ausandavno/ISA_POST_Card_v5/README.md

# ISA_POST_Card_v5
A plug-in diagnostic card that displays Power On Self Test (POST) codes on an 8-bit ISA data bus. Tested for use with Micro8088 and Xi8088 systems. Can be configured to listen on any address in the lower ten bits of address space. 

Current version v5.1
