ausandavno/ISA_POST_Card_v5/v5.1/CAD/README.md

Various footprints, symbols, and 3D models that may be required for KiCad to import the project correctly.
