ausandavno/ISA_POST_Card_v5/v5.1/Images/ISA_Post_Card_v5.1_3.PNG

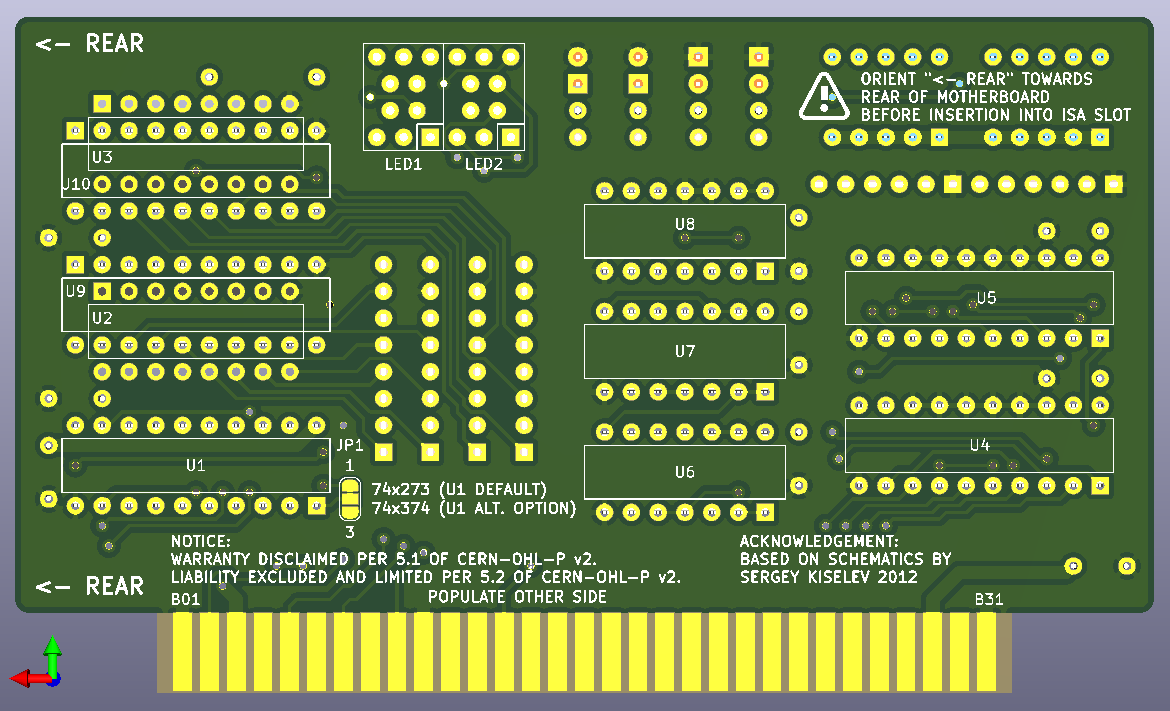
v5.1/Images/ISA_Post_Card_v5.1_3.PNG
