ausandavno/ISA_POST_Card_v5/v5.1/CAD/LTS_2801AG_Assembly.stp

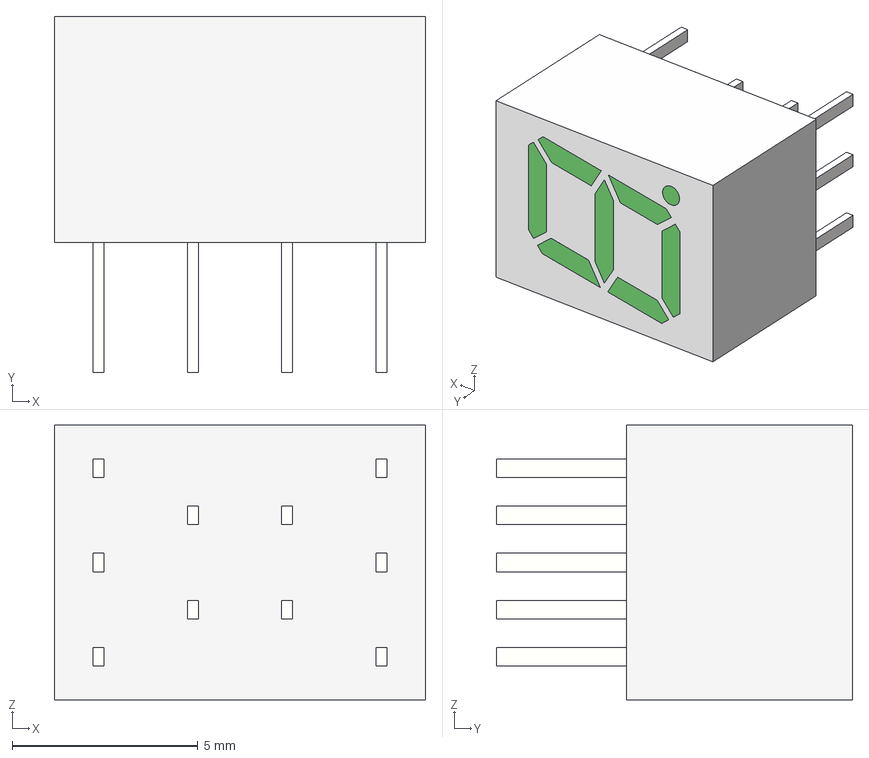
[picture p4: CAD file, 2022-04-07]
v5.1/CAD/LTS_2801AG_Assembly.stp
10.0 x 9.60 x 7.40 mm
