ausandavno/ISA_POST_Card_v5/v5.1/PCB_Layout/ISA_POST_Card_v5.1-B_Cu.pdf

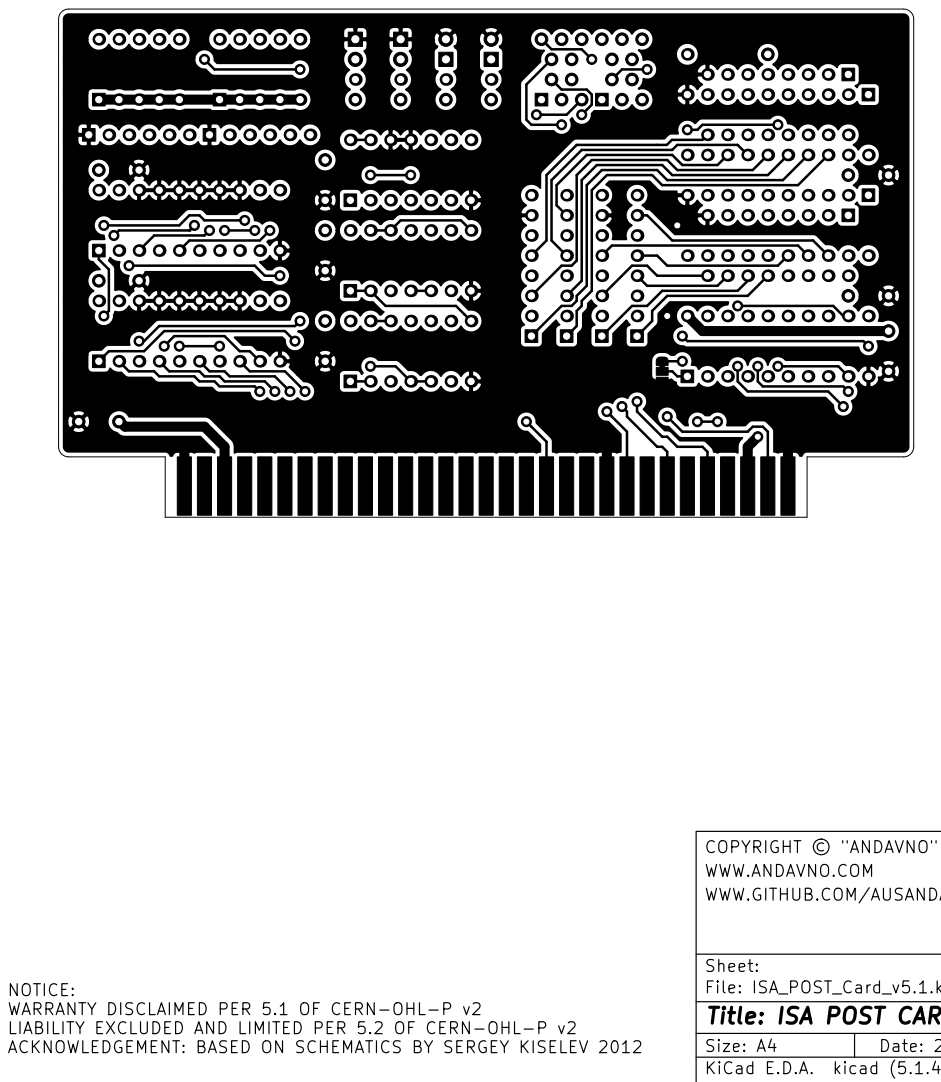
[picture p5: page 1]

COPYRIGHT © "ANDAVNO" 2022
ACKNOWLEDGEMENT: BASED ON SCHEMATICS BY SERGEY KISELEV 2012 WWW.GITHUB.COM/AUSANDAVNO WWW.ANDAVNO.COM

Id: 1/1 Title: ISA POST CARD v5.1

WARRANTY DISCLAIMED PER 5.1 OF CERN-OHL-P v2

LIABILITY EXCLUDED AND LIMITED PER 5.2 OF CERN-OHL-P v2
