ausandavno/ISA_POST_Card_v5/v5.1/Schematics/ISA_POST_Card_v5.1-Schematic.pdf

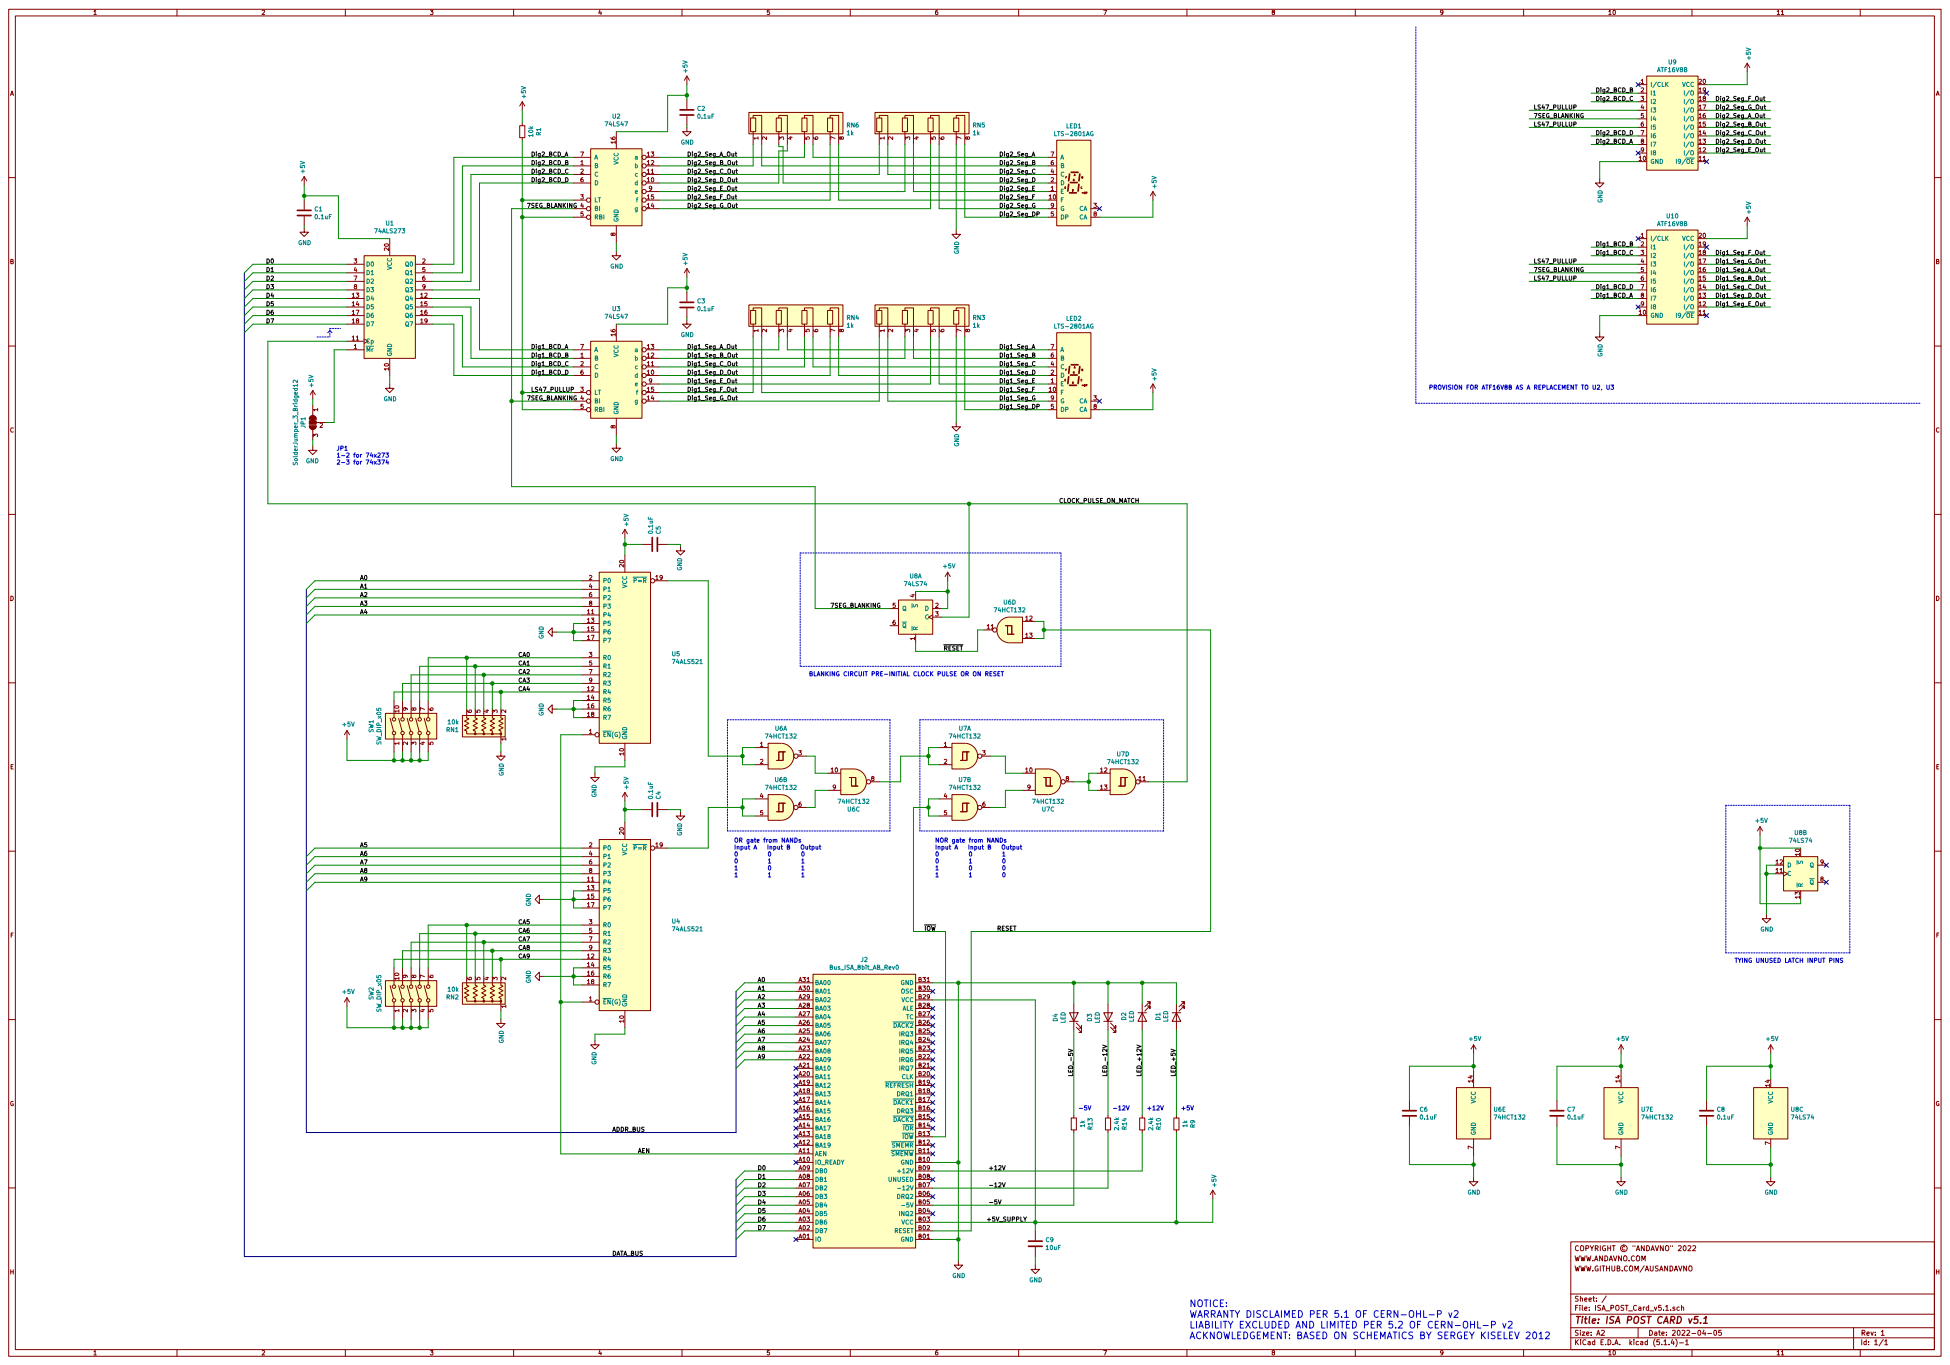
[picture p6: page 1]

Dig2_Seg_F
Dig2_Seg_G
Dig2_Seg_DP

Dig1_Seg_F
Dig1_Seg_G
Dig1_Seg_DP

PROVISION FOR ATF16V8B AS A REPLACEMENT TO U2, U3

OR gate from NANDs

TYING UNUSED LATCH INPUT PINS

File: ISA_POST_Card_v5.1.sch Sheet: / WWW.GITHUB.COM/AUSANDAVNO WWW.ANDAVNO.COM

WARRANTY DISCLAIMED PER 5.1 OF CERN-OHL-P v2
LIABILITY EXCLUDED AND LIMITED PER 5.2 OF CERN-OHL-P v2
ACKNOWLEDGEMENT: BASED ON SCHEMATICS BY SERGEY KISELEV 2012

Id: 1/1 Title: ISA POST CARD v5.1
