ausandavno/ISA_POST_Card_v5/v5.1/ISA_POST_Card_v5.1.kicad_pcb

## KiCad design v5.1/ISA_POST_Card_v5.1.kicad_pcb (2022-04-07)

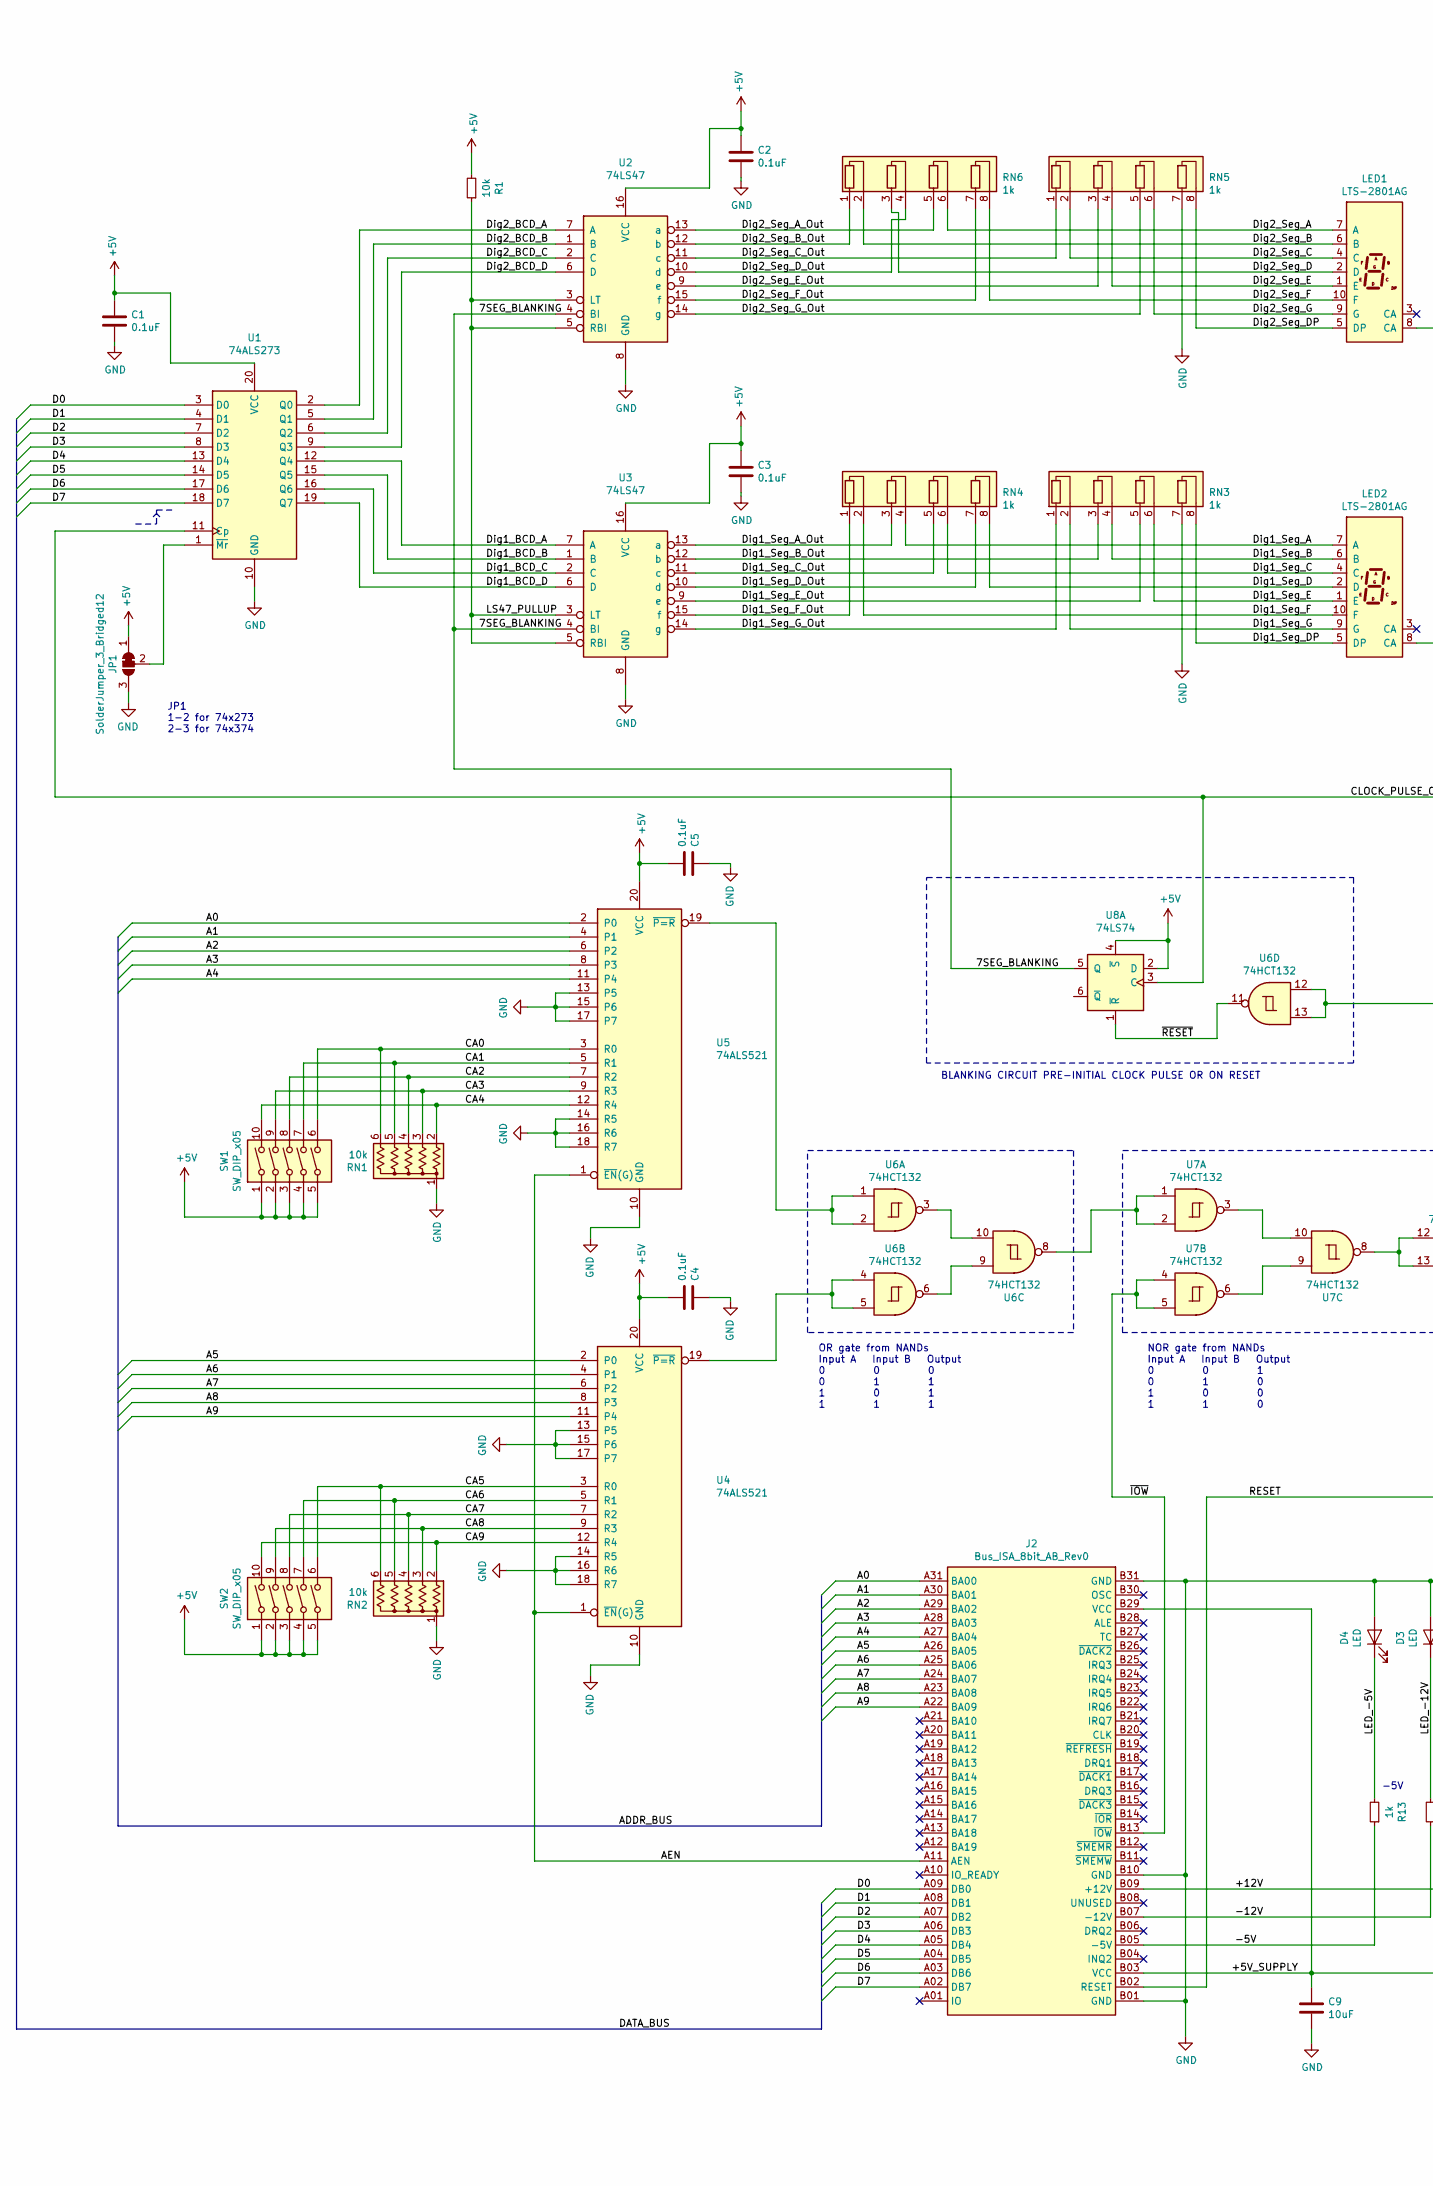
[picture p7: schematic ISA_POST_Card_v5.1.sch, ISA POST CARD v5.1, part in row 1, column 1]

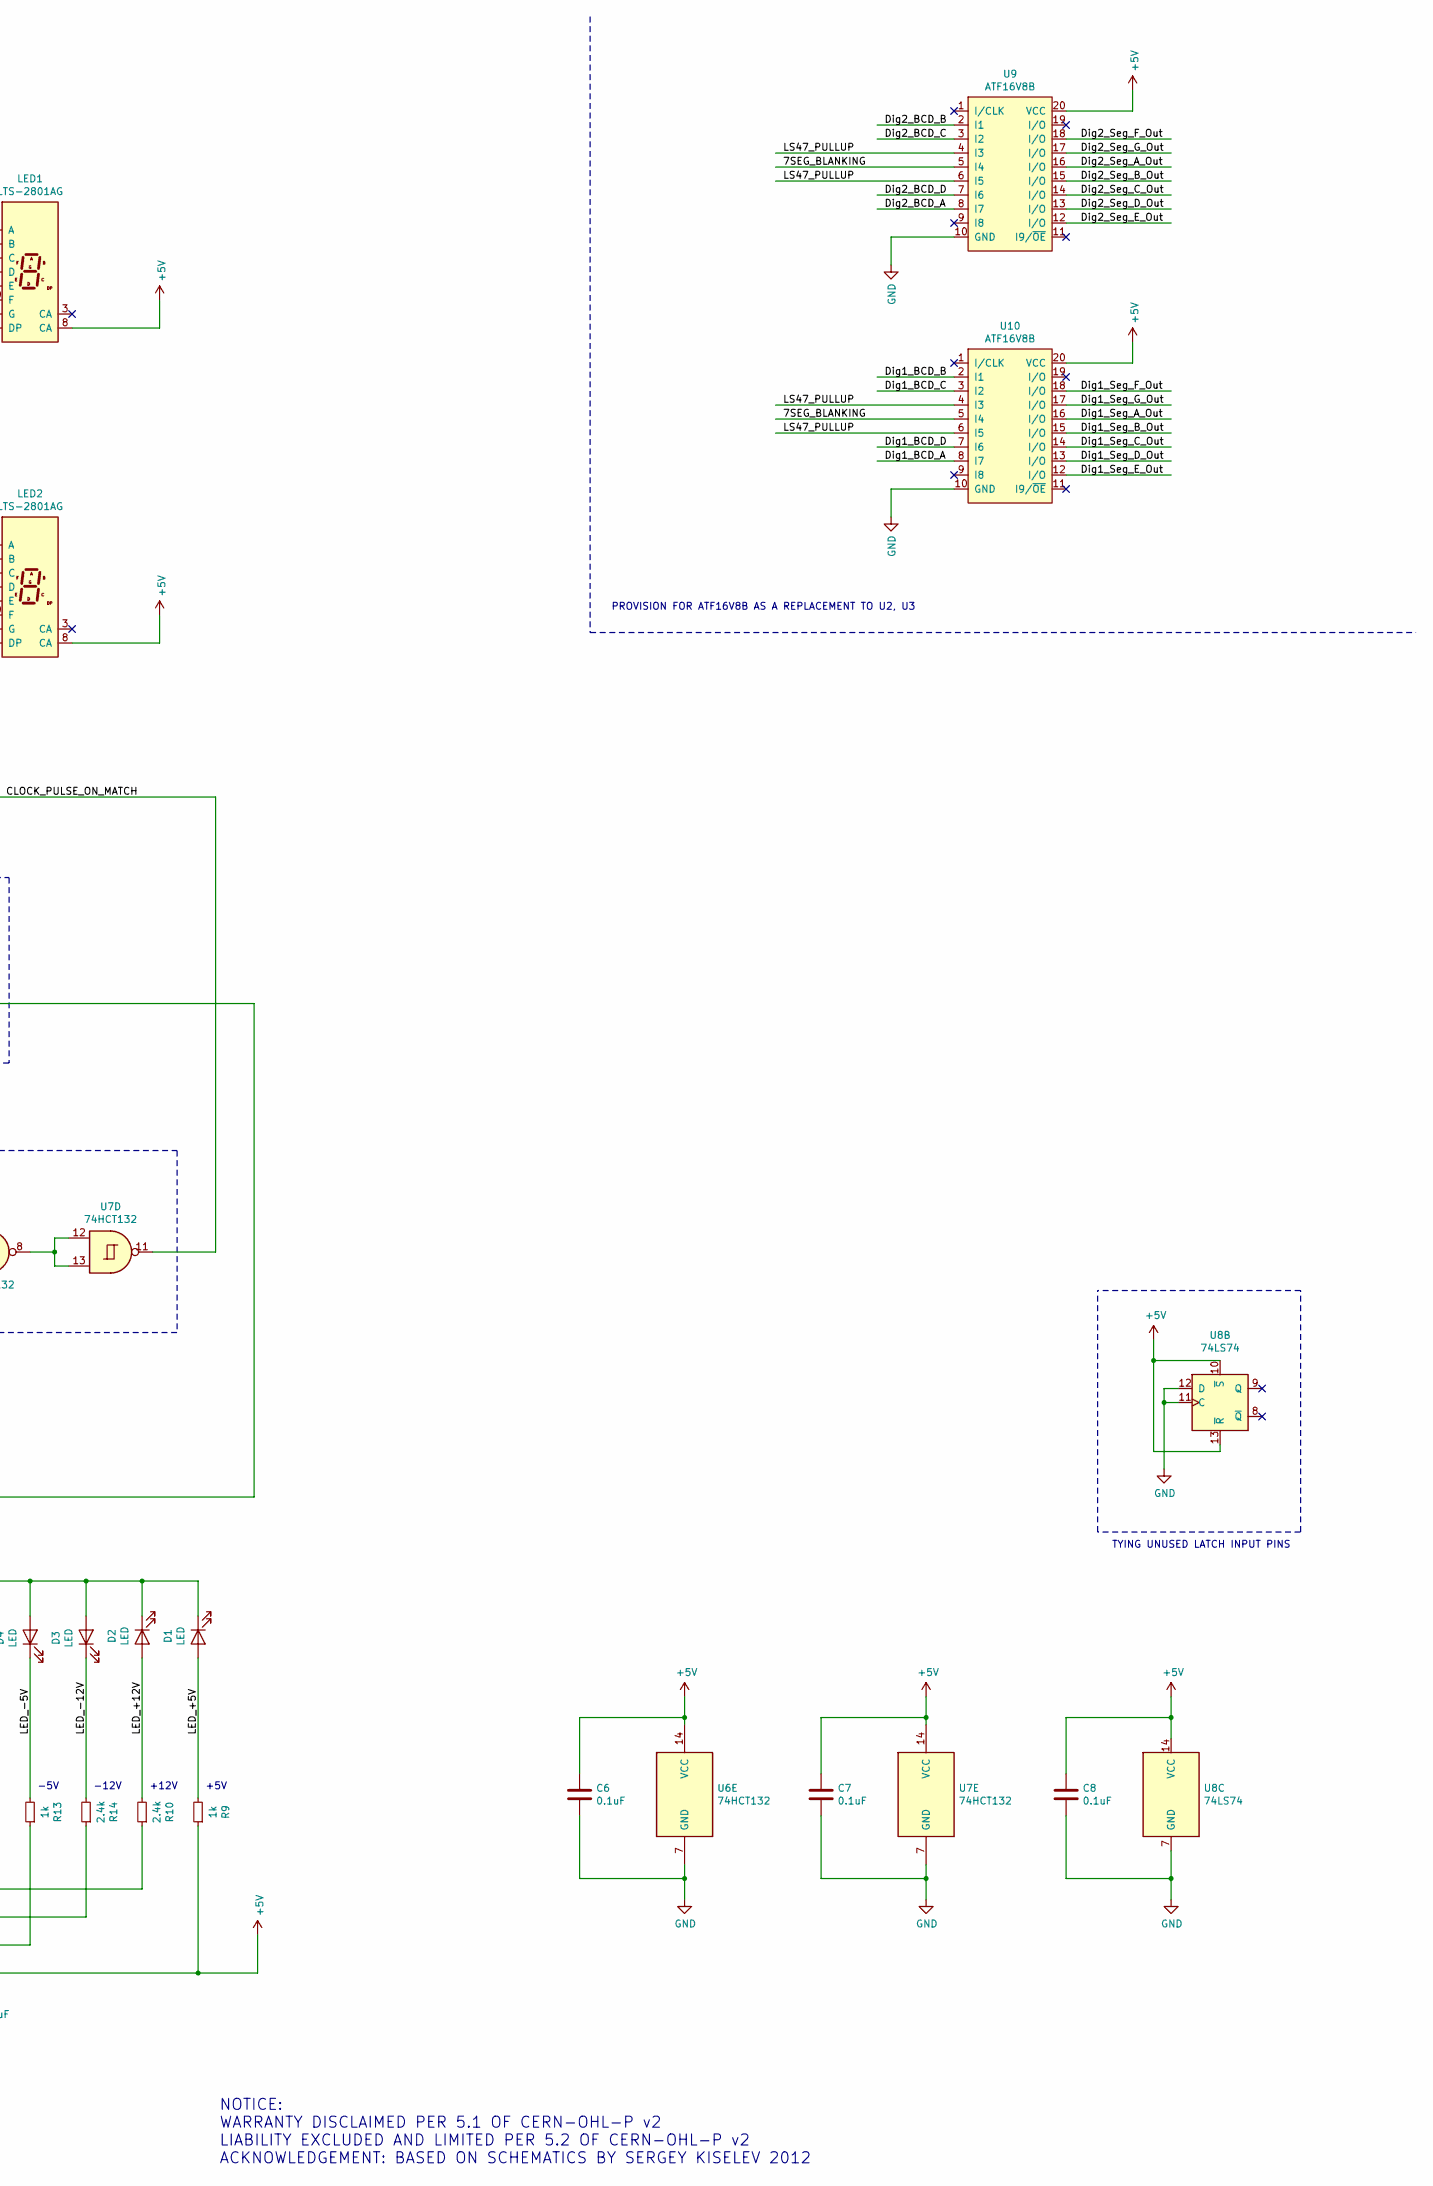
[picture p8: schematic ISA_POST_Card_v5.1.sch, ISA POST CARD v5.1, part in row 1, column 2]

Parts:
C1, C2, C3, C4, C5, C6, C7, C8: 0.1uF; C_Disc_D4.3mm_W1.9mm_P5.08mm
C9: 10uF; C_Disc_D4.3mm_W1.9mm_P5.08mm
D1, D2, D3, D4: LED; LED_D3.0mm
J2: Bus_ISA_8bit_AB_Rev0; ISA_CARD_EDGE_CONNECTOR_8BIT_Rev1
JP1: SolderJumper_3_Bridged12; SolderJumper-3_P1.3mm_Bridged12_RoundedPad1.0x1.5mm_NumberL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
LED1, LED2: LTS-2801AG
R1: 10k; R_Axial_DIN0207_L6.3mm_D2.5mm_P10.16mm_Horizontal
R9, R13: 1k; R_Axial_DIN0207_L6.3mm_D2.5mm_P2.54mm_Vertical
R10, R14: 2.4k; R_Axial_DIN0207_L6.3mm_D2.5mm_P2.54mm_Vertical
RN1, RN2: 10k; R_Array_SIP6
RN3, RN4, RN5, RN6: 1k; R_Array_SIP8
SW1, SW2: SW_DIP_x05; SW_DIP_SPSTx05_Slide_9.78x14.88mm_W7.62mm_P2.54mm
U1: 74ALS273; DIP-20_W7.62mm
U2, U3: 74LS47; DIP-16_W7.62mm
U4, U5: 74ALS521; DIP-20_W7.62mm
U6, U7: 74HCT132; DIP-14_W7.62mm
U8: 74LS74; DIP-14_W7.62mm
U9, U10: ATF16V8B; DIP-20_W7.62mm

Connections:
+5V: C1.1, C2.1, C3.1, C4.2, C5.2, C6.1, C7.1, C8.1, C9.1, J2.B03 (VCC), J2.B29 (VCC), JP1.1 (A), LED1.8 (CA), LED2.8 (CA), R1.2, R9.1, SW1.1, SW1.2, SW1.3, SW1.4, SW1.5, SW2.1, SW2.2, SW2.3, SW2.4, SW2.5, U1.20 (VCC), U2.16 (VCC), U3.16 (VCC), U4.20 (VCC), U5.20 (VCC), U6.14 (VCC), U7.14 (VCC), U8.2 (D), U8.4 (~S), U8.10 (~S), U8.13 (~R), U8.14 (VCC), U9.20 (VCC), U10.20 (VCC)
/7SEG_BLANKING: U2.4 (BI), U3.4 (BI), U8.5 (Q), U9.5 (I4), U10.5 (I4)
/+12V: J2.B09 (+12V), R10.1
/-5V: J2.B05 (-5V), R13.1
/-12V: J2.B07 (-12V), R14.1
/A0: J2.A31 (BA00), U5.2 (P0)
/A1: J2.A30 (BA01), U5.4 (P1)
/A2: J2.A29 (BA02), U5.6 (P2)
/A3: J2.A28 (BA03), U5.8 (P3)
/A4: J2.A27 (BA04), U5.11 (P4)
/A5: J2.A26 (BA05), U4.2 (P0)
/A6: J2.A25 (BA06), U4.4 (P1)
/A7: J2.A24 (BA07), U4.6 (P2)
/A8: J2.A23 (BA08), U4.8 (P3)
/A9: J2.A22 (BA09), U4.11 (P4)
/AEN: J2.A11 (AEN), U4.1 (~EN~(G)), U5.1 (~EN~(G))
/CA0: RN1.6 (R5), SW1.6, U5.3 (R0)
/CA1: RN1.5 (R4), SW1.7, U5.5 (R1)
/CA2: RN1.4 (R3), SW1.8, U5.7 (R2)
/CA3: RN1.3 (R2), SW1.9, U5.9 (R3)
/CA4: RN1.2 (R1), SW1.10, U5.12 (R4)
/CA5: RN2.6 (R5), SW2.6, U4.3 (R0)
/CA6: RN2.5 (R4), SW2.7, U4.5 (R1)
/CA7: RN2.4 (R3), SW2.8, U4.7 (R2)
/CA8: RN2.3 (R2), SW2.9, U4.9 (R3)
/CA9: RN2.2 (R1), SW2.10, U4.12 (R4)
/CLOCK_PULSE_ON_MATCH: U1.11 (Cp), U7.11, U8.3 (C)
/D0: J2.A09 (DB0), U1.3 (D0)
/D1: J2.A08 (DB1), U1.4 (D1)
/D2: J2.A07 (DB2), U1.7 (D2)
/D3: J2.A06 (DB3), U1.8 (D3)
/D4: J2.A05 (DB4), U1.13 (D4)
/D5: J2.A04 (DB5), U1.14 (D5)
/D6: J2.A03 (DB6), U1.17 (D6)
/D7: J2.A02 (DB7), U1.18 (D7)
/Dig1_BCD_A: U1.12 (Q4), U3.7 (A), U10.8 (I7)
/Dig1_BCD_B: U1.15 (Q5), U3.1 (B), U10.2 (I1)
/Dig1_BCD_C: U1.16 (Q6), U3.2 (C), U10.3 (I2)
/Dig1_BCD_D: U1.19 (Q7), U3.6 (D), U10.7 (I6)
/Dig1_Seg_A: LED2.7 (A), RN4.4 (R2.2)
/Dig1_Seg_A_Out: RN4.3 (R2.1), U3.13 (a), U10.16 (I/O)
/Dig1_Seg_B: LED2.6 (B), RN3.4 (R2.2)
/Dig1_Seg_B_Out: RN3.3 (R2.1), U3.12 (b), U10.15 (I/O)
/Dig1_Seg_C: LED2.4 (C), RN4.6 (R3.2)
/Dig1_Seg_C_Out: RN4.5 (R3.1), U3.11 (c), U10.14 (I/O)
/Dig1_Seg_D: LED2.2 (D), RN4.8 (R4.2)
/Dig1_Seg_DP: LED2.5 (DP), RN3.8 (R4.2)
/Dig1_Seg_D_Out: RN4.7 (R4.1), U3.10 (d), U10.13 (I/O)
/Dig1_Seg_E: LED2.1 (E), RN3.6 (R3.2)
/Dig1_Seg_E_Out: RN3.5 (R3.1), U3.9 (e), U10.12 (I/O)
/Dig1_Seg_F: LED2.10 (F), RN4.2 (R1.2)
/Dig1_Seg_F_Out: RN4.1 (R1.1), U3.15 (f), U10.18 (I/O)
/Dig1_Seg_G: LED2.9 (G), RN3.2 (R1.2)
/Dig1_Seg_G_Out: RN3.1 (R1.1), U3.14 (g), U10.17 (I/O)
/Dig2_BCD_A: U1.2 (Q0), U2.7 (A), U9.8 (I7)
/Dig2_BCD_B: U1.5 (Q1), U2.1 (B), U9.2 (I1)
/Dig2_BCD_C: U1.6 (Q2), U2.2 (C), U9.3 (I2)
/Dig2_BCD_D: U1.9 (Q3), U2.6 (D), U9.7 (I6)
/Dig2_Seg_A: LED1.7 (A), RN6.6 (R3.2)
/Dig2_Seg_A_Out: RN6.5 (R3.1), U2.13 (a), U9.16 (I/O)
/Dig2_Seg_B: LED1.6 (B), RN6.2 (R1.2)
/Dig2_Seg_B_Out: RN6.1 (R1.1), U2.12 (b), U9.15 (I/O)
/Dig2_Seg_C: LED1.4 (C), RN5.2 (R1.2)
/Dig2_Seg_C_Out: RN5.1 (R1.1), U2.11 (c), U9.14 (I/O)
/Dig2_Seg_D: LED1.2 (D), RN6.3 (R2.1)
/Dig2_Seg_DP: LED1.5 (DP), RN5.8 (R4.2)
/Dig2_Seg_D_Out: RN6.4 (R2.2), U2.10 (d), U9.13 (I/O)
/Dig2_Seg_E: LED1.1 (E), RN5.4 (R2.2)
/Dig2_Seg_E_Out: RN5.3 (R2.1), U2.9 (e), U9.12 (I/O)
/Dig2_Seg_F: LED1.10 (F), RN6.8 (R4.2)
/Dig2_Seg_F_Out: RN6.7 (R4.1), U2.15 (f), U9.18 (I/O)
/Dig2_Seg_G: LED1.9 (G), RN5.6 (R3.2)
/Dig2_Seg_G_Out: RN5.5 (R3.1), U2.14 (g), U9.17 (I/O)
/LED_+5V: D1.2 (A), R9.2
/LED_+12V: D2.2 (A), R10.2
/LED_-5V: D4.1 (K), R13.2
/LED_-12V: D3.1 (K), R14.2
/LS47_PULLUP: R1.1, U2.3 (LT), U2.5 (RBI), U3.3 (LT), U3.5 (RBI), U9.4 (I3), U9.6 (I5), U10.4 (I3), U10.6 (I5)
/RESET: J2.B02 (RESET), U6.12, U6.13
/~IOW~: J2.B13 (~IOW), U7.4, U7.5
/~RESET~: U6.11, U8.1 (~R)
GND: C1.2, C2.2, C3.2, C4.1, C5.1, C6.2, C7.2, C8.2, C9.2, D1.1 (K), D2.1 (K), D3.2 (A), D4.2 (A), J2.B01 (GND), J2.B10 (GND), J2.B31 (GND), JP1.3 (B), RN1.1 (common), RN2.1 (common), RN3.7 (R4.1), RN5.7 (R4.1), U1.10 (GND), U2.8 (GND), U3.8 (GND), U4.10 (GND), U4.13 (P5), U4.14 (R5), U4.15 (P6), U4.16 (R6), U4.17 (P7), U4.18 (R7), U5.10 (GND), U5.13 (P5), U5.14 (R5), U5.15 (P6), U5.16 (R6), U5.17 (P7), U5.18 (R7), U6.7 (GND), U7.7 (GND), U8.7 (GND), U8.11 (C), U8.12 (D), U9.10 (GND), U10.10 (GND)
unnamed: JP1.2 (C), U1.1 (~Mr)
unnamed: U4.19 (~P=R~), U6.4, U6.5
unnamed: U5.19 (~P=R~), U6.1, U6.2
unnamed: U6.6, U6.9
unnamed: U6.8, U7.1, U7.2
unnamed: U6.3, U6.10
unnamed: U7.6, U7.9
unnamed: U7.3, U7.10
unnamed: U7.8, U7.12, U7.13

Notes on the sheet:
PROVISION FOR ATF16V8B AS A REPLACEMENT TO U2, U3
-5V
-12V
+5V
+12V
OR gate from NANDs Input A Input B Output 0 0 0 0 1 1 1 0 1 1 1 1
NOR gate from NANDs Input A Input B Output 0 0 1 0 1 0 1 0 0 1 1 0
JP1 1-2 for 74x273 2-3 for 74x374
BLANKING CIRCUIT PRE-INITIAL CLOCK PULSE OR ON RESET
TYING UNUSED LATCH INPUT PINS
NOTICE: WARRANTY DISCLAIMED PER 5.1 OF CERN-OHL-P v2 LIABILITY EXCLUDED AND LIMITED PER 5.2 OF CERN-OHL-P v2 ACKNOWLEDGEMENT: BASED ON SCHEMATICS BY SERGEY KISELEV 2012

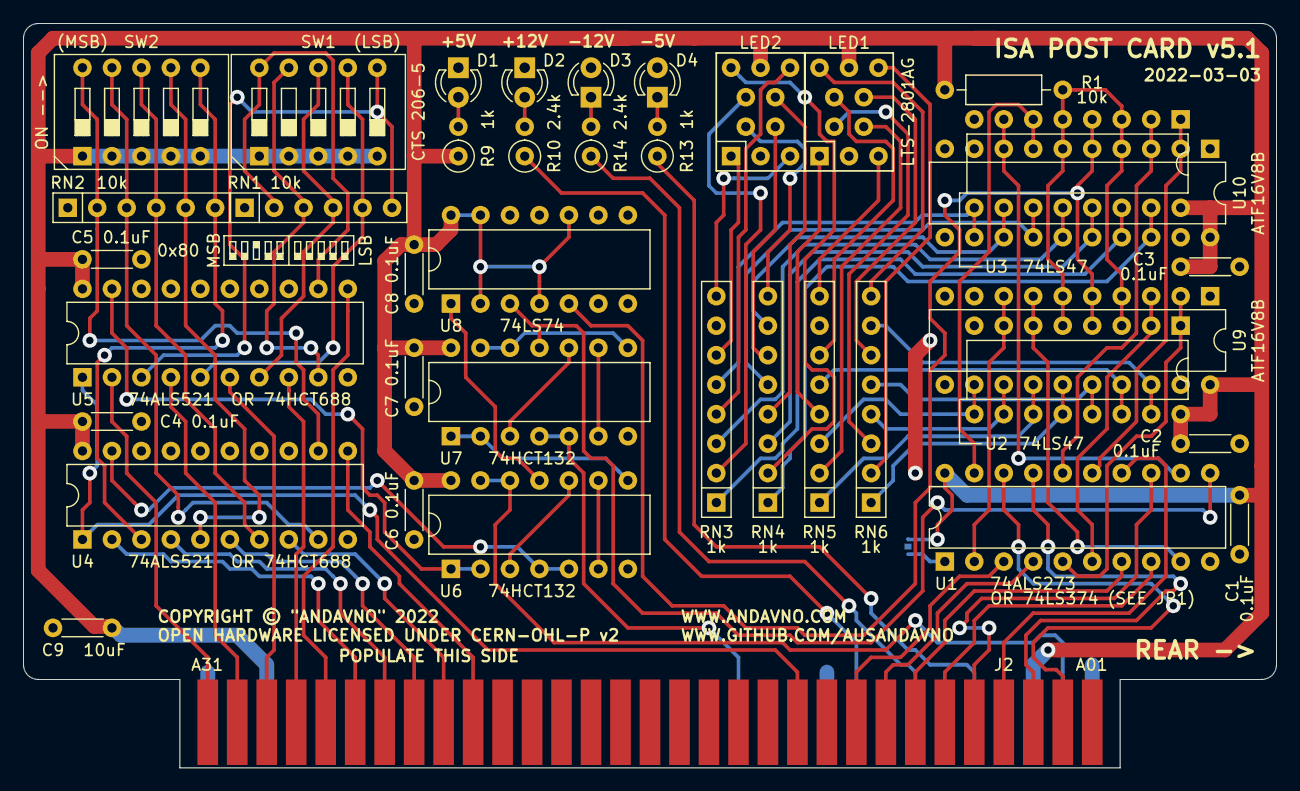
[picture p9: board ISA_POST_Card_v5.1.kicad_pcb from above]

Board: 2 copper layers, 108.0 x 64.1 mm, 40 parts (1 on the bottom side), 91 nets.
