ausandavno/ISA_POST_Card_v5/(notices)

Notices in the files:
v5.1/ISA_POST_Card_v5.1.kicad_pcb:
OPEN HARDWARE LICENSED UNDER CERN-OHL-P v2
